SeanSylwester/Senior-Design-Project/Block Descriptions/Old/Laser Block.docx

# Laser ToF Sensor

# I. Introduction

The purpose of this document is to describe the Laser Time of Flight (ToF) Sensor block of the Wearable Sensor for the Blind ECE Senior Capstone Project to other engineers with enough detail such that they would be able to reproduce and test this block using only this document as reference. The Laser ToF block is implemented using a band of many VL53L0X ToF Ranging Sensor from ST Microelectronics on Adafruit breakout boards. Included in this document are an overview of the block, a schematic and wiring diagram, the properties of the interfaces with the other blocks in the system and testing procedures for each, and reasoning for why this design is the best solution for this block.

# II. Block Overview

The Laser ToF Sensor block will provide the distance to the nearest object in six 60° zones around the user to the system, which will use that information to set the system haptic feedback module that will convey that distance information to the user. The measurements taken need to be fast and accurate, so that the user can quickly and confidently navigate around obstacles in their environment. Fig. 1 below shows the black box diagram of the system. otsd_lsr_tf_snsr_envin represents the environmental input to this block, namely the distance to the nearest objects. lsr_tf_snsr_cntrllr_cd_data represents the I²C input from the microcontroller, which triggers measurements for the sensors and programs the ranging profile. pwr_spply_lsr_tf_snsr_dcpwr represents the connection to the power supply, which is regulated to 5V, and should draw about 30mA per sensor during measurements. And finally, cntrllr_cd_lsr_tf_snsr_data represents the I²C data output from this block to the microcontroller. All the properties for these interfaces can be found in Table 1.

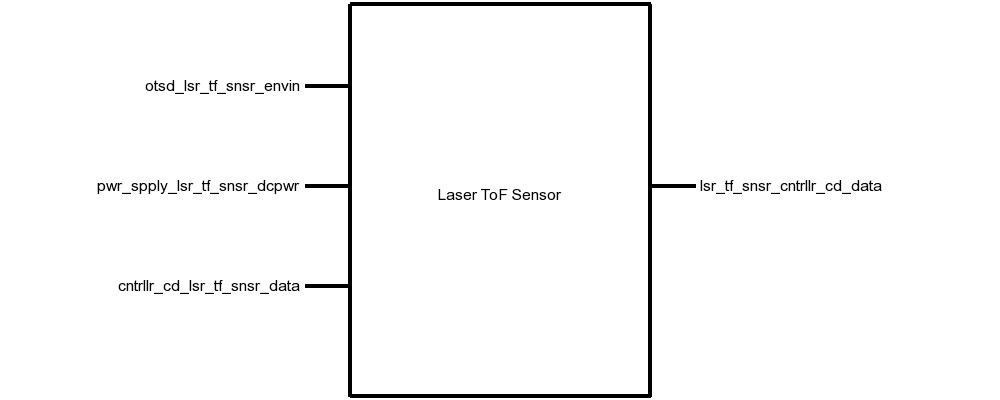
[picture p39: figure]

Fig. 1. Black Box Diagram of the Laser ToF Sensor Block
TABLE I.  Laser ToF Sensor Block Interfaces and Properties

Name | Properties
otsd_lsr_tf_snsr_envin | - Other: Accuracy: 12% - Other: Range: 0.4m(Black) 1m(White) - Other: Angle: 5° - Other: Measurement Time: 60ms
lsr_tf_snsr_cntrllr_cd_data | - Datarate: 115.2kHz - Messages: Sensor Data - Other: Measurement Time: 60ms - Protocol: I2C
cntrllr_cd_lsr_tf_snsr_data | - Datarate: 115.2kHz - Messages: Address Programming, Measurement Trigger, Measurement Read - Other: Measurement Time: 60ms - Protocol: I2C
pwr_spply_lsr_tf_snsr_dcpwr | - Inominal: 20µA ± 10% per sensor (between measurements) - Ipeak: 30mA per sensor (during measurement) - Vmax: 5V - Vmin: 3V

# III. Verification

This section details the testing procedures to verify every property listed in Table 1. All tests must be passed successfully before this block will be integrated into the rest of the system. Testing will be completed using a single Adafruit breakout board.

## A. Power and Communication Testing

This test will verify the power requirements for this block on the pwr_spply_lsr_tf_snsr_dcpwr interface, and the communication requirements on the cntrllr_cd_lsr_tf_snsr_data and lsr_tf_snsr_cntrllr_cd_data interfaces.

1. Connect a VL53L0X sensor to a DC power supply that can display current, set to 3V, via the pwr_spply_lsr_tf_snsr_dcpwr interface.
2. Connect a microcontroller using I2C at 115.2kHz to the cntrllr_cd_lsr_tf_snsr_data and lsr_tf_snsr_cntrllr_cd_data interfaces.
3. Load a test program on the microcontroller than takes a measurement for 200ms, then idles for 200ms.
4. Note the current displayed on the DC power supply during a measurement, and during idle.
5. Repeat steps 1-4 with the DC power supply set to 5V.

PASS: This test passes if the current draw never exceeds 30mA, and if the I2C interface communication links at 115.2kHz.

Link to Video (https://drive.google.com/drive/u/1/folders/1-_lIgtS_F6LOhz8X-mATpoxzoEysoKYl)

## B. Measurement

This test will verify the measurement requirements for this block on the otsd_lsr_tf_snsr_envin interface.

1. Connect a VL53L0X sensor to a DC power supply set to 2.8V via the pwr_spply_lsr_tf_snsr_dcpwr interface.
2. Connect a microcontroller using I2C at 115.2kHz to the cntrllr_cd_lsr_tf_snsr_data and lsr_tf_snsr_cntrllr_cd_data interfaces.
3. Load a test program on the microcontroller than takes a measurement for 60ms, then prints out the distance measurement, then idles for 40ms.
4. Place a white object 1m directly in front of the sensor and note if the sensor detects the object.
5. Place a black object 0.4m directly in front of the sensor and note if the sensor detects the object.
6. Place a white object 30cm away, and 3cm off-center (5°) and note if the sensor detects the object.
7. Place a white object 30cm directly in front of the sensor and note if the distance measurement is within 10% of 50cm.

PASS: If the the measurements complete in less than 60ms, objects in steps 4, 5, and 6 were detected, and the object in step 7 was detected within 10%.

Link to Video (https://drive.google.com/drive/u/1/folders/1-_lIgtS_F6LOhz8X-mATpoxzoEysoKYl)

# IV. Design

The schematic in Fig. 2 presents this block’s design, including the interfaces of this block to the rest of the system. Table 2 provides validation for each of the properties listed in Table 1 using the ST Microelectronics datasheet and the Adafruit .

## A. Wiring Diagram

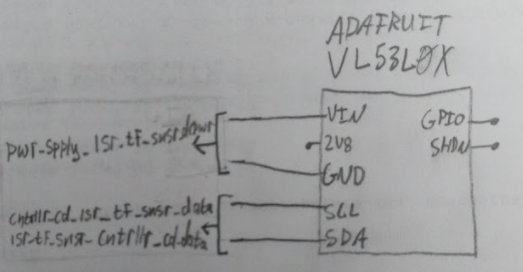
[picture p40: figure]

Fig. 2. Wiring Diagram for the Laser ToF Sensor Block

## B. Design Validation

For this block, the Adafruit breakout board was chosen to interface with the VL53L0X sensor. That sensor was chosen because it fits the low cost, low power, medium range, high accuracy, and fast performance that this project required of the Laser ToF Sensor block, and the breakout board was chosen to reduce prototyping time, and to reduce the number of components that need to be sourced for this block.

TABLE II.  Interface Property Validation for the DIsplay Block

Property | Validation

otsd_lsr_tf_snsr_envin
Other: Accuracy: 12% | Table 12 of the VL53L0X Datasheet states that the worst-case accuracy is 12% [1].
Other: Range: 0.4m(Black) 1m(White) | Table 11 of the VL53L0X Datasheet states that the minimum range indoors is 1.2m for a white object, and 0.7m for a grey object [1].
Other: Angle: 5° | VL53L0X Datasheet states that the FOV of the sensor is 25° [1].
Other: Measurement Time: 60ms | Table 13 of the VL53L0X Datasheet states that minimum timing budget is 20ms [1].

lsr_tf_snsr_cntrllr_cd_data
Datarate: 115.2kHz | Table 3 of the VL53L0X Datasheet states that the maximum I2C operating frequency is 400kHz
Messages: Sensor Data | Section 2 of the VL53L0X Datasheet states that Sensor Data can be sent over I2C [1].
Other: Measurement Time: 60ms | Table 13 of the VL53L0X Datasheet states that minimum timing budget is 20ms [1].
Protocol: I2C | Section 3 of the VL53L0X Datasheet states that I2C is the control interface required [1].

cntrllr_cd_lsr_tf_snsr_data
Datarate: 115.2kHz | Table 3 of the VL53L0X Datasheet states that the maximum I2C operating frequency is 400kHz
Messages: Address Programming, Measurement Trigger, Measurement Read | Section 2 of the VL53L0X Datasheet states that Address Programming, Measurement Trigger, and Measurement Read commands can be sent over I2C [1].
Other: Measurement Time: 60ms | Table 13 of the VL53L0X Datasheet states that minimum timing budget is 20ms [1].
Protocol: I2C | Section 3 of the VL53L0X Datasheet states that I2C is the control interface required [1].

pwr_spply_lsr_tf_snsr_dcpwr
Inominal: 20µA ± 10% per sensor (between measurements) | Table 9 of the VL53L0X Datasheet states that the inter-measurement current consumption is 16µA [1].
Ipeak: 30mA per sensor (during measurement) | Table 9 of the VL53L0X Datasheet states that the measurement current consumption is 19mA [1].
Vmax: 5V | The overview page for the Adafruit breakout board specifies that the input voltage range is 3-5V [2].
Vmin: 3V | The overview page for the Adafruit breakout board specifies that the input voltage range is 3-5V [2].

##### References

[1] ST Microelectronics, “World smallest Time-of-Flight ranging and gesture detection sensor,” VL53L0X production datasheet, May 2016
[2] Adafruit and T. Dicola, “Adafruit VL53L0X Time of Flight Micro-LIDAR Distance Sensor Breakout,” Adafruit VL53L0X Time of Flight Micro-LIDAR Distance Sensor Breakout, 23-Nov-2016. [Online]. Available: https://learn.adafruit.com/adafruit-vl53l0x-micro-lidar-distance-sensor-breakout/overview. [Accessed: 03-Dec-2017].
