SeanSylwester/Senior-Design-Project/PCB stuff/OLD/layout.pdf

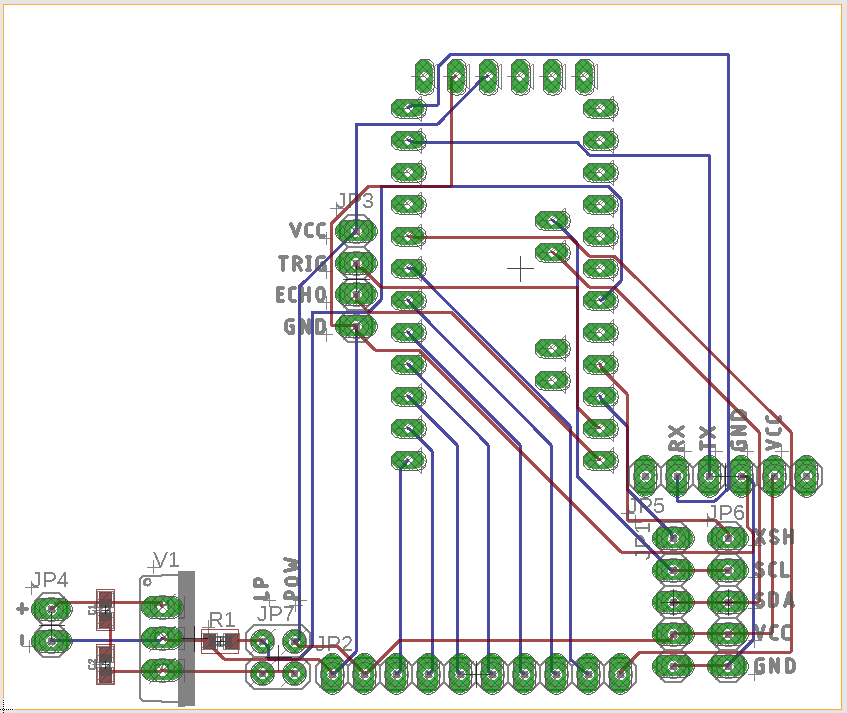
[picture p43: page 1]
