SeanSylwester/Senior-Design-Project/PCB stuff/OLD/PCB Layout.pdf

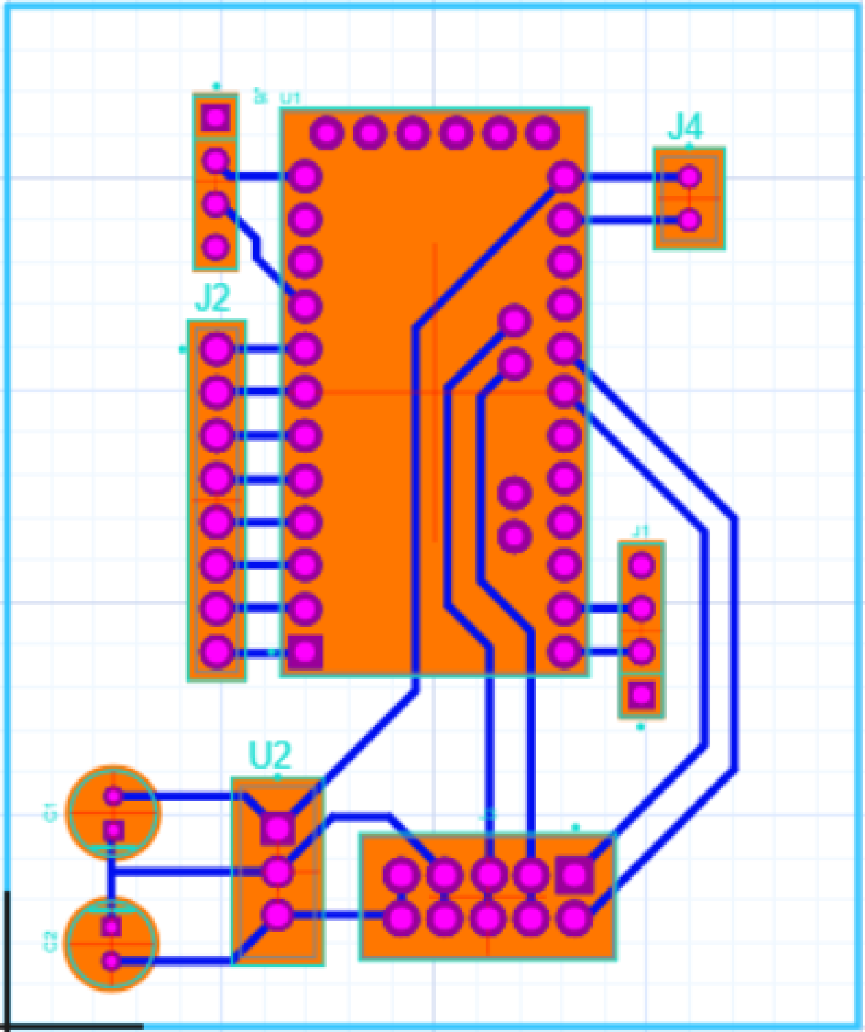
[picture p44: page 1]
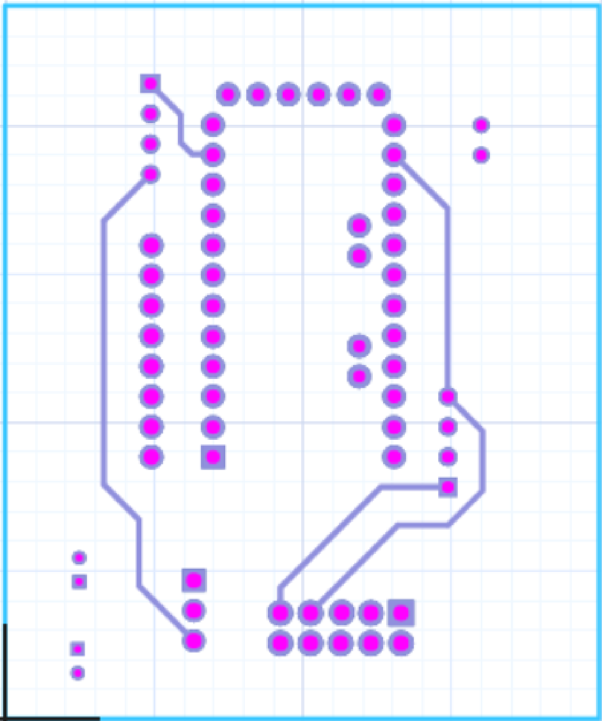
[picture p45: page 2]
