SeanSylwester/Senior-Design-Project/PCB stuff/OLD/Laser Sensor PCB/Old/VL53L0X Layout.pdf

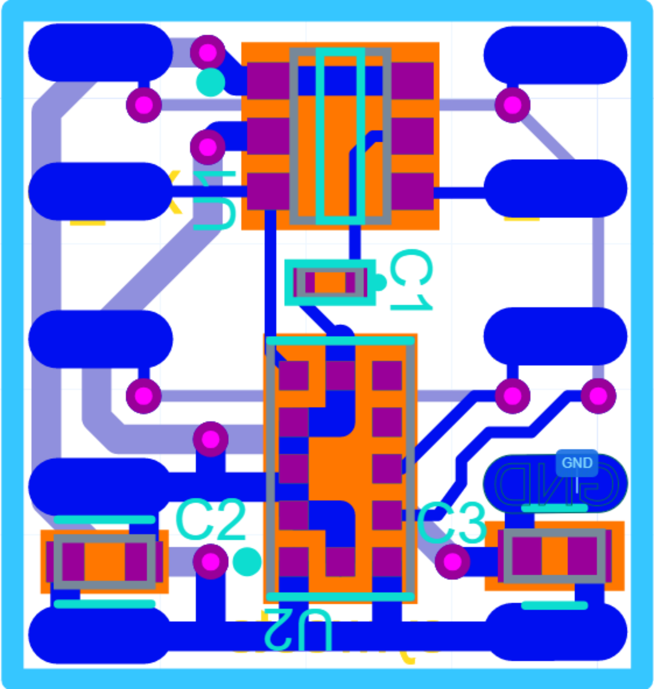
[picture p46: page 1]
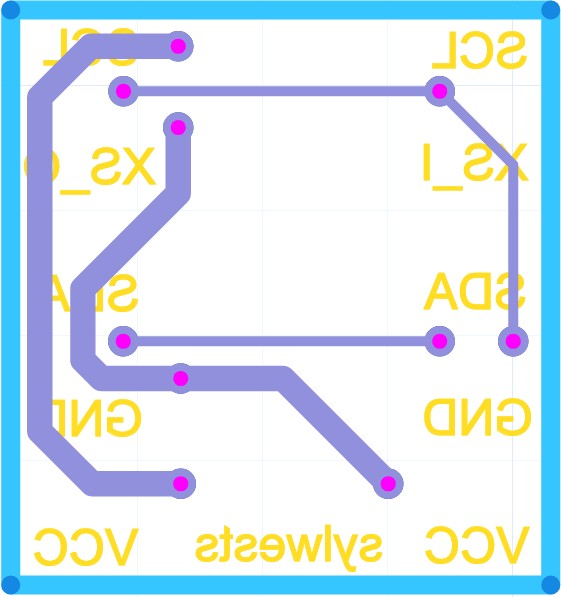
[picture p47: page 2]
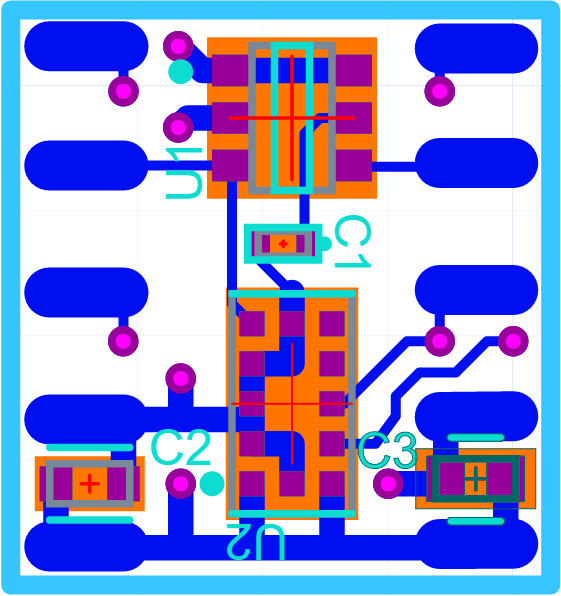
[picture p48: page 3]
