SeanSylwester/Senior-Design-Project/black box diagram.jpg

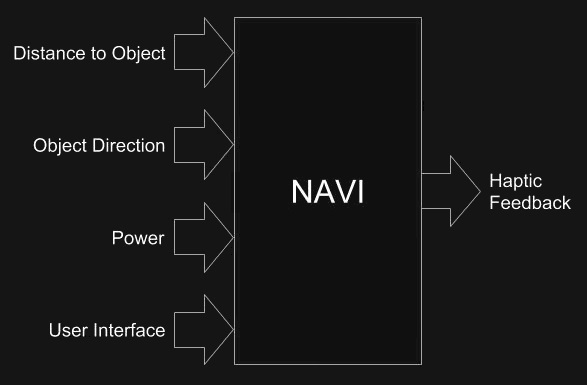
black box diagram.jpg
