SeanSylwester/Senior-Design-Project/Laser Sensor PCB/New/Bottom.PNG

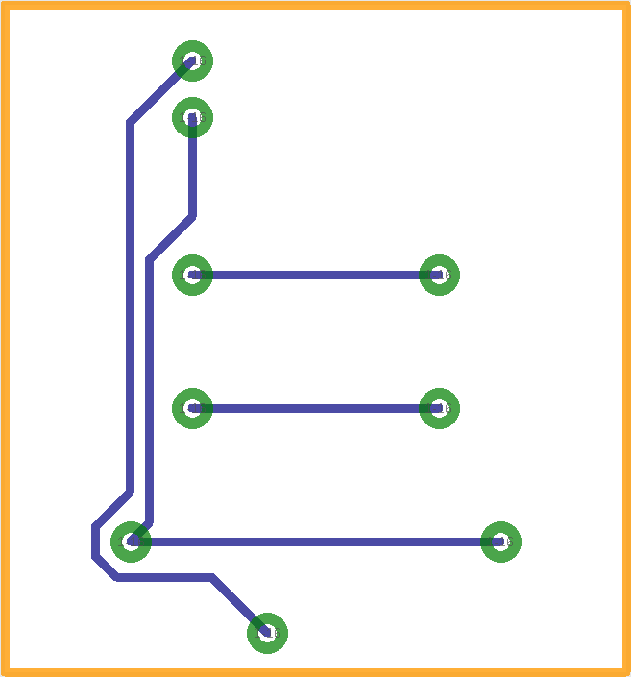
Laser Sensor PCB/New/Bottom.PNG
