SeanSylwester/Senior-Design-Project/Laser Sensor PCB/New/Bottom_Labeled.PNG

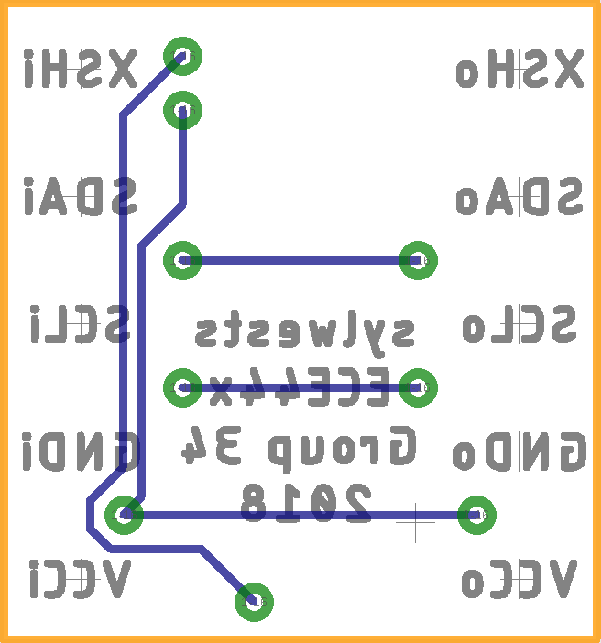
Laser Sensor PCB/New/Bottom_Labeled.PNG
