SeanSylwester/Senior-Design-Project/Laser Sensor PCB/New/Schematic.PNG

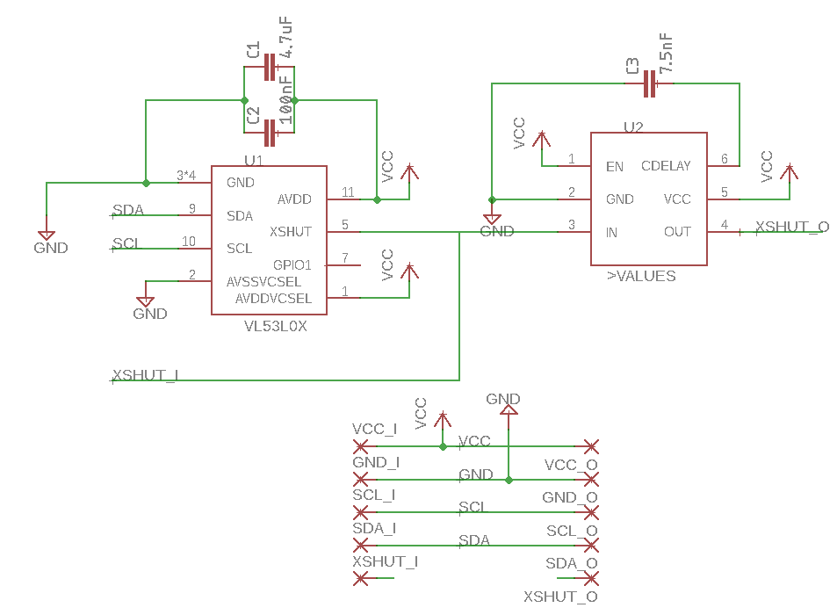
Laser Sensor PCB/New/Schematic.PNG
