SeanSylwester/Senior-Design-Project/Laser Sensor PCB/New/Top.PNG

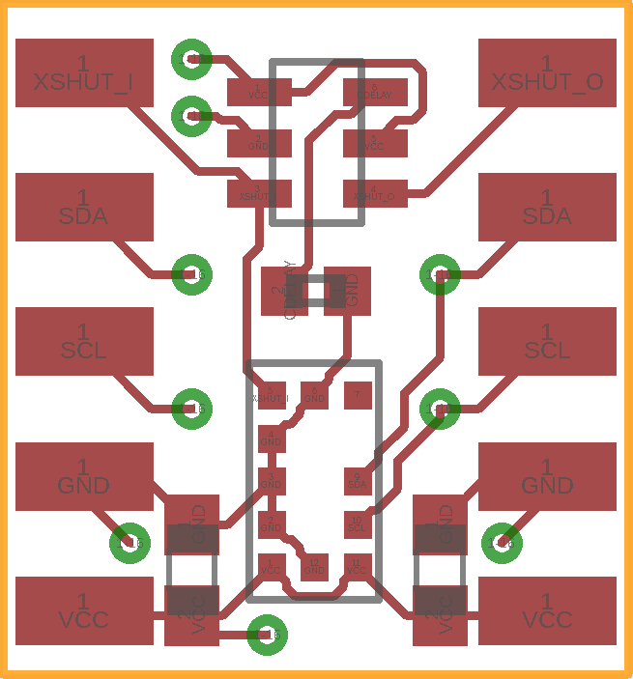
Laser Sensor PCB/New/Top.PNG
