SeanSylwester/Senior-Design-Project/system block diagram.png

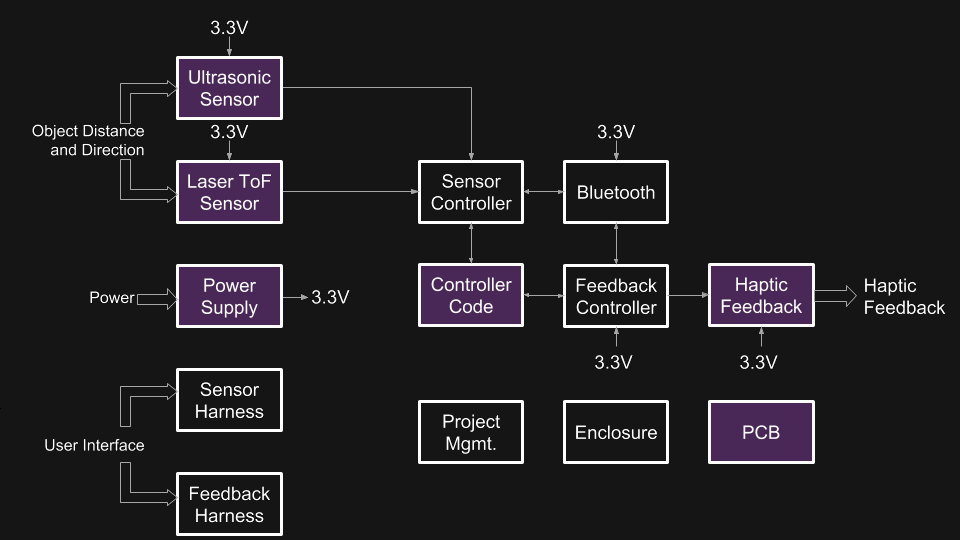
system block diagram.png
