SeanSylwester/Senior-Design-Project/Timeline.png

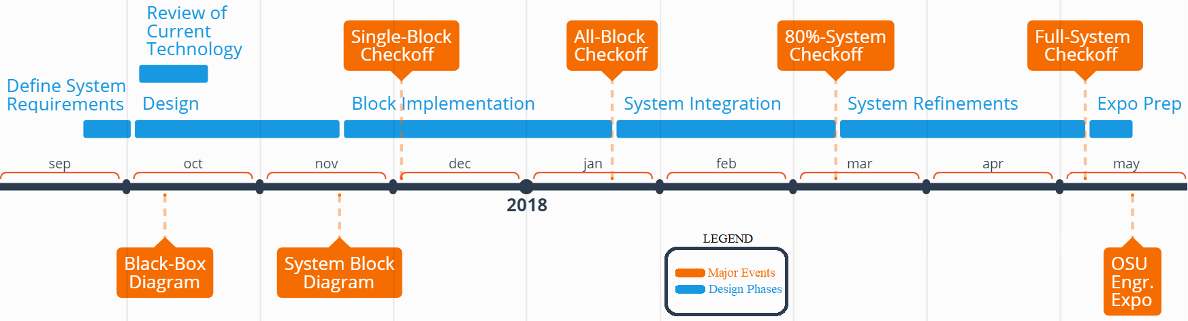
Timeline.png
