SeanSylwester/Senior-Design-Project/PCB stuff/OLD/PCB Schematic.pdf

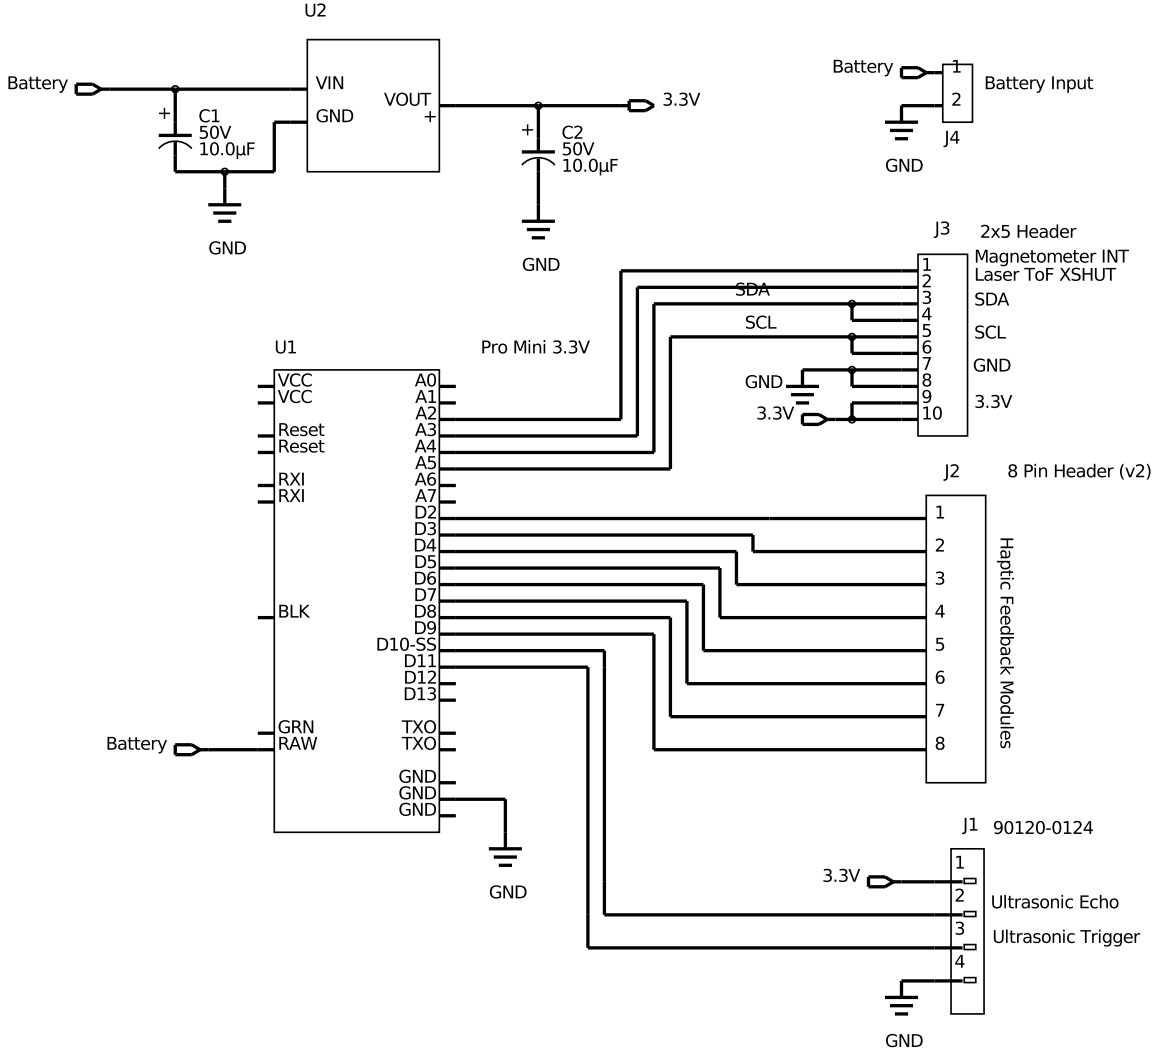
[picture p56: page 1]
