SeanSylwester/Senior-Design-Project/PCB stuff/OLD/Laser Sensor PCB/Old/VL53L0X Schematic.pdf

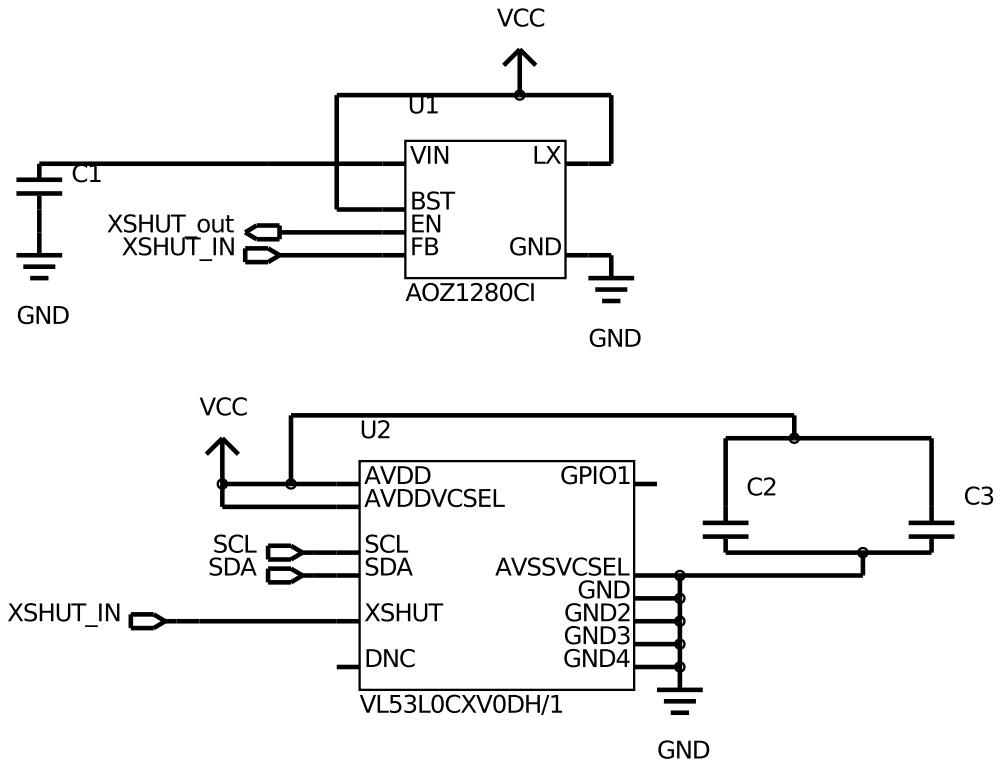
[picture p57: page 1]
