SeanSylwester/Senior-Design-Project/PCB stuff/motor PCB/motor_PCB.brd

## EAGLE design PCB stuff/motor PCB/motor_PCB.brd (2020-01-28)

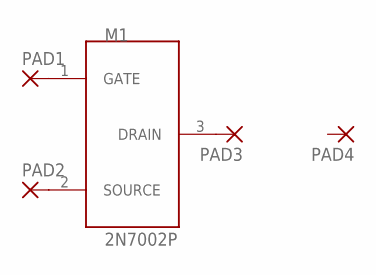
[picture p58: schematic motor_PCB.sch]

Parts:
M1: 2N7002P; TO-236AB
PAD1, PAD2, PAD3, PAD4: SMD2; SMD1,27-2,54

Connections:
unnamed: M1.1 (GATE), PAD1.1
unnamed: M1.2 (SOURCE), PAD2.1
unnamed: M1.3 (DRAIN), PAD3.1

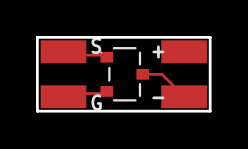
[picture p59: board motor_PCB.brd from above]

Board: 2 copper layers, 9.6 x 4.1 mm, 5 parts (0 on the bottom side), 3 nets.
