SeanSylwester/Senior-Design-Project/PCB stuff/VL53L0X Board/Schematic.brd

## EAGLE design PCB stuff/VL53L0X Board/Schematic.brd (2020-01-28)

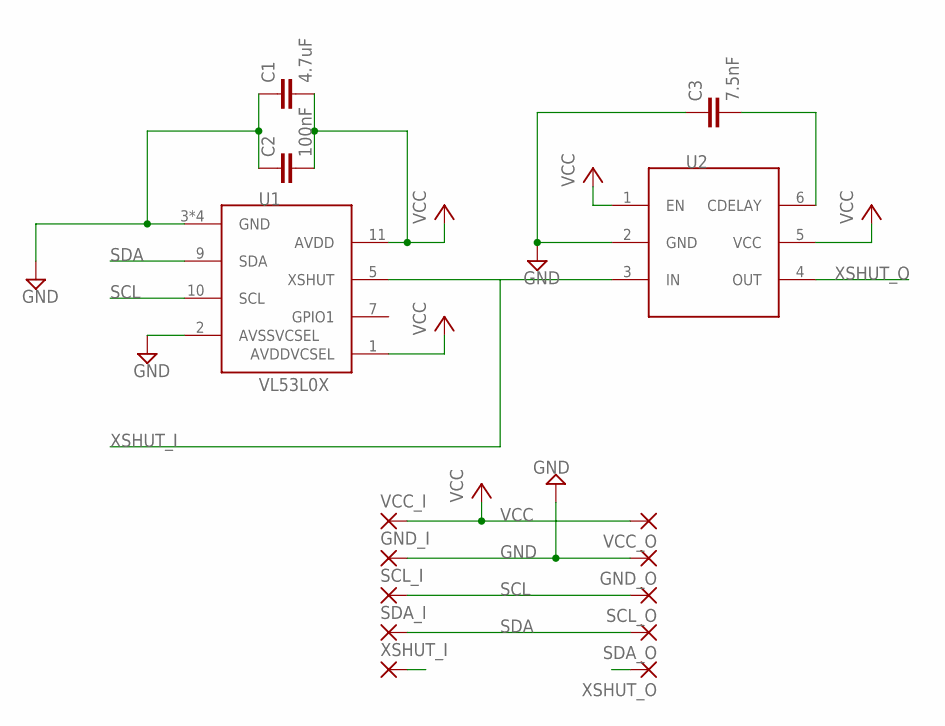
[picture p60: schematic Schematic.sch]

Parts:
C1: 4.7uF; 0603
C2: 100nF; 0603
C3: 7.5nF; 0402
GND_I: SMD2; SMD1,27-2,54
GND_O: SMD2; SMD1,27-2,54
SCL_I: SMD2; SMD1,27-2,54
SCL_O: SMD2; SMD1,27-2,54
SDA_I: SMD2; SMD1,27-2,54
SDA_O: SMD2; SMD1,27-2,54
U1: VL53L0X; OPTICAL_LGA12
U2: MAX6895AAZT+T; 6-THIN-SOT23
VCC_I: SMD2; SMD1,27-2,54
VCC_O: SMD2; SMD1,27-2,54
XSHUT_I: SMD2; SMD1,27-2,54
XSHUT_O: SMD2; SMD1,27-2,54

Connections:
CDELAY: C3.2, U2.6 (CDELAY)
GND: C1.1, C2.1, C3.1, GND_I.1, GND_O.1, U1.2 (AVSSVCSEL), U1.3 (GND), U1.4 (GND), U1.6 (GND), U1.12 (GND), U2.2 (GND)
SCL: SCL_I.1, SCL_O.1, U1.10 (SCL)
SDA: SDA_I.1, SDA_O.1, U1.9 (SDA)
VCC: C1.2, C2.2, U1.1 (AVDDVCSEL), U1.11 (AVDD), U2.1 (EN), U2.5 (VCC), VCC_I.1, VCC_O.1
XSHUT_I: U1.5 (XSHUT), U2.3 (IN), XSHUT_I.1
XSHUT_O: U2.4 (OUT), XSHUT_O.1

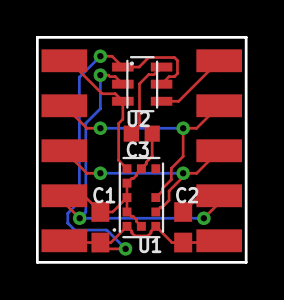
[picture p61: board Schematic.brd from above]

Board: 2 copper layers, 11.6 x 12.5 mm, 15 parts (0 on the bottom side), 7 nets.
