SeanSylwester/Senior-Design-Project/PCB stuff/sensor band/sensor_PCB.brd

## EAGLE design PCB stuff/sensor band/sensor_PCB.brd (2020-01-28)

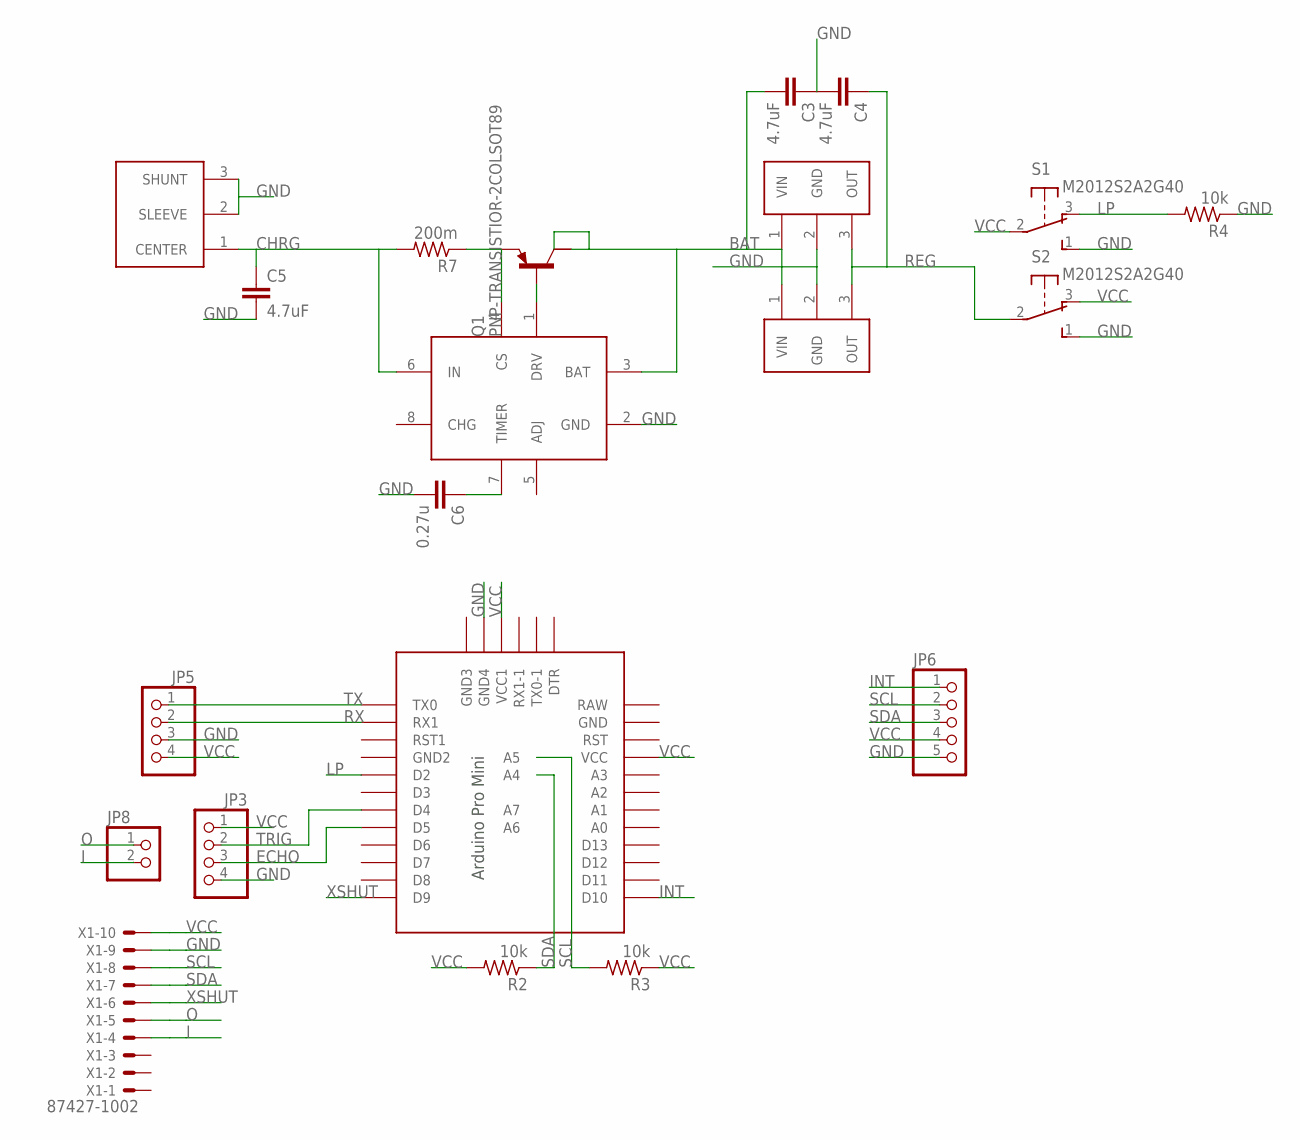
[picture p62: schematic sensor_PCB.sch]

Parts:
C3, C4, C5: 4.7uF; 0603
C6: 0.27u; 0805
JP3, JP5: PINHD-1X4; 1X04
JP6: PINHD-1X5; 1X05
JP8: PINHD-1X2; 1X02
Q1: PNP-TRANSISTIOR-2COLSOT89; SOT89
R2, R3, R4: 10k; R0603
R7: 200m; R0603
S1, S2: M2012S2A2G40
U$1: PRO-MINI-2
U$3: ADP2291; 8-MSOP
V3, V4: UCC283T-3; TO220V
V5: L712RAS
X1: 87427-1002

Connections:
BAT: C3.2, Q1.2 (C), Q1.2@1 (C/), U$3.3 (BAT), V3.1 (VIN), V4.1 (VIN)
CHRG: C5.1, R7.2, U$3.6 (IN), V5.1 (CENTER)
CS: Q1.3 (E), R7.1, U$3.4 (CS)
DRV: Q1.1 (B), U$3.1 (DRV)
ECHO: JP3.3, U$1.D5
GND: C3.1, C4.2, C5.2, C6.2, JP3.4, JP5.3, JP6.5, R4.1, S1.1 (S), S2.1 (S), U$1.GND3 (GND4), U$3.2 (GND), V3.2 (GND), V4.2 (GND), V5.2 (SLEEVE), V5.3 (SHUNT), X1.9
I: JP8.2, X1.4
INT: JP6.1, U$1.D10
LP: R4.2, S1.3 (O), U$1.D2
O: JP8.1, X1.5
REG: C4.1, S2.2, V3.3 (OUT), V4.3 (OUT)
RX: JP5.2, U$1.RX1
SCL: JP6.2, R3.2, U$1.A5, X1.8
SDA: JP6.3, R2.1, U$1.A4, X1.7
TIMER: C6.1, U$3.7 (TIMER)
TRIG: JP3.2, U$1.D4
TX: JP5.1, U$1.TX0
VCC: JP3.1, JP5.4, JP6.4, R2.2, R3.1, S1.2, S2.3 (O), U$1.VCC, U$1.VCC1, X1.10
XSHUT: U$1.D9, X1.6

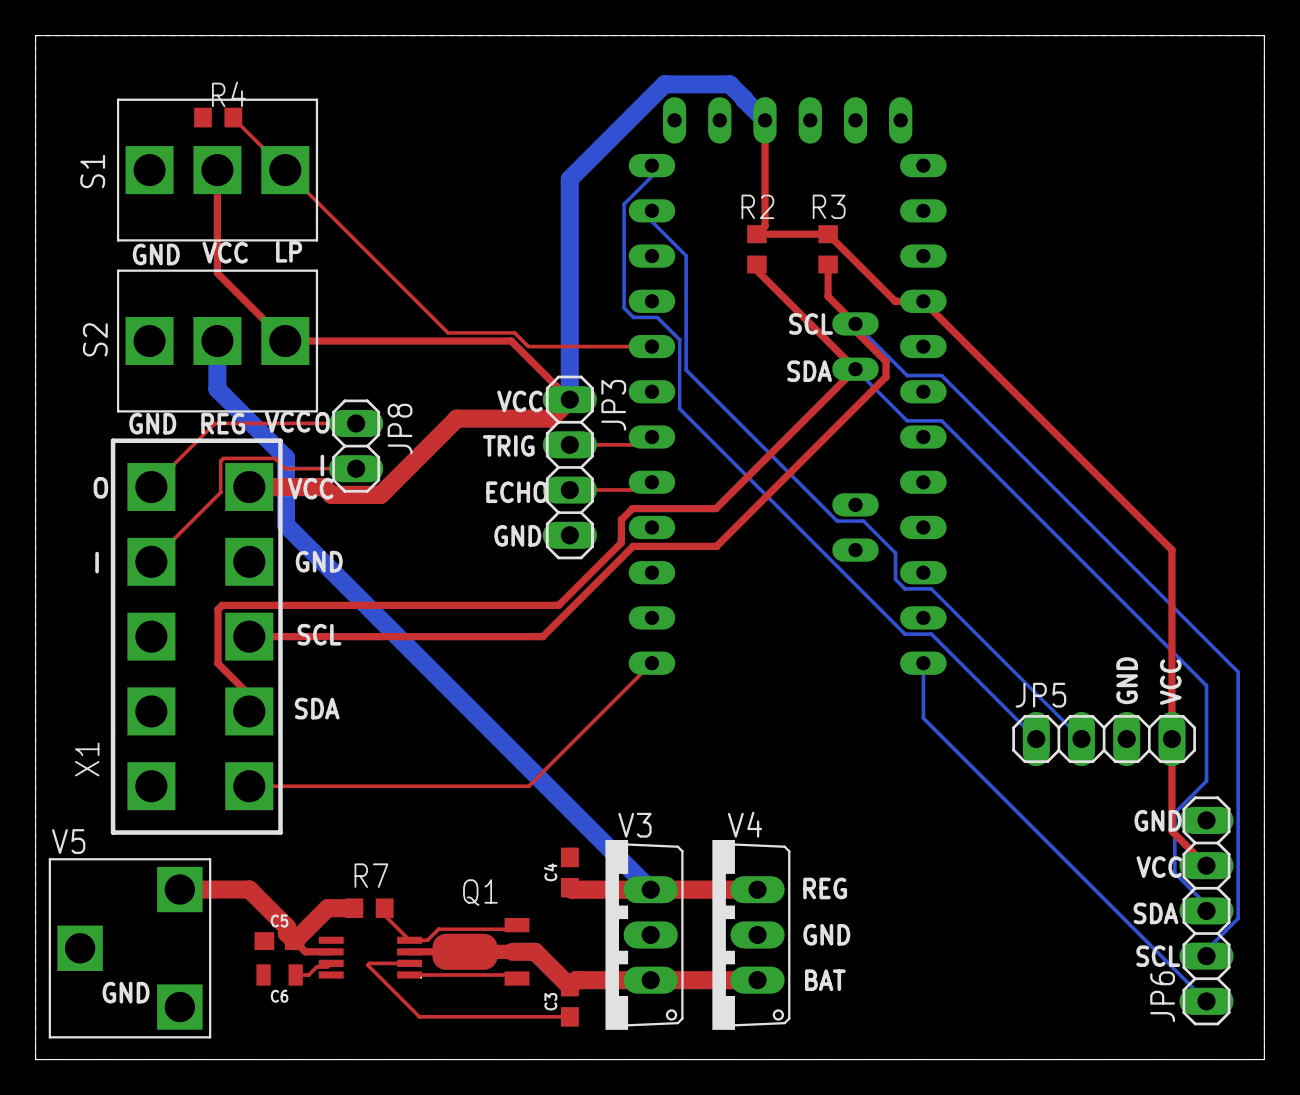
[picture p63: board PCB stuff/sensor band/sensor_PCB.brd from above]

Board: 2 copper layers, 69.0 x 57.5 mm, 21 parts (0 on the bottom side), 19 nets.
