SeanSylwester/Senior-Design-Project/eagle/sensor PCB/sensor_PCB.brd

## EAGLE design eagle/sensor PCB/sensor_PCB.brd (2020-01-28)

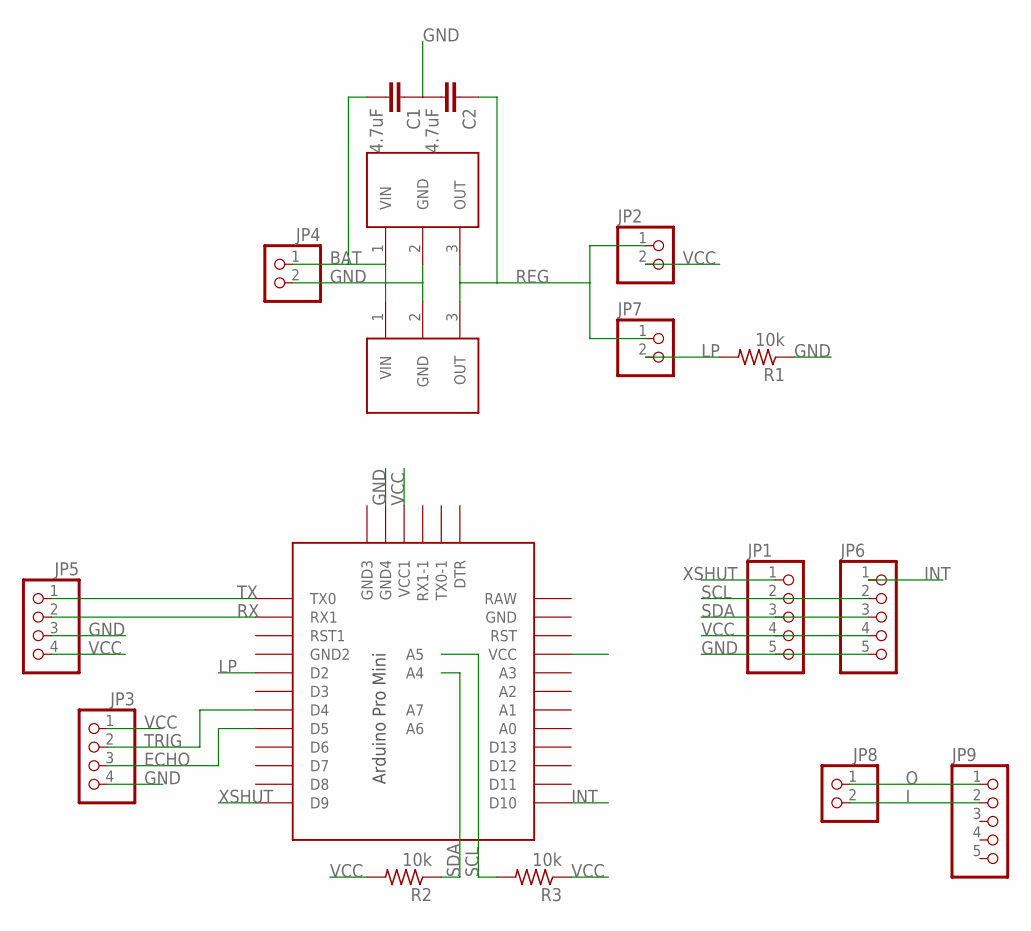
[picture p64: schematic sensor_PCB.sch]

Parts:
C1, C2: 4.7uF; 0603
JP1, JP6, JP9: PINHD-1X5; 1X05
JP2, JP4, JP7, JP8: PINHD-1X2; 1X02
JP3, JP5: PINHD-1X4; 1X04
R1, R2, R3: 10k; R0603
U$1: PRO-MINI-2
V1, V2: UCC283T-3; TO220V

Connections:
BAT: C1.2, JP4.1, V1.1 (VIN), V2.1 (VIN)
ECHO: JP3.3, U$1.D5
GND: C1.1, C2.2, JP1.5, JP3.4, JP4.2, JP5.3, JP6.5, R1.1, U$1.GND3 (GND4), V1.2 (GND), V2.2 (GND)
I: JP8.2, JP9.2
INT: JP6.1, U$1.D10
LP: JP7.2, R1.2, U$1.D2
O: JP8.1, JP9.1
REG: C2.1, JP2.1, JP7.1, V1.3 (OUT), V2.3 (OUT)
RX: JP5.2, U$1.RX1
SCL: JP1.2, JP6.2, R3.2, U$1.A5
SDA: JP1.3, JP6.3, R2.1, U$1.A4
TRIG: JP3.2, U$1.D4
TX: JP5.1, U$1.TX0
VCC: JP1.4, JP2.2, JP3.1, JP5.4, JP6.4, R2.2, R3.1, U$1.VCC1
XSHUT: JP1.1, U$1.D9

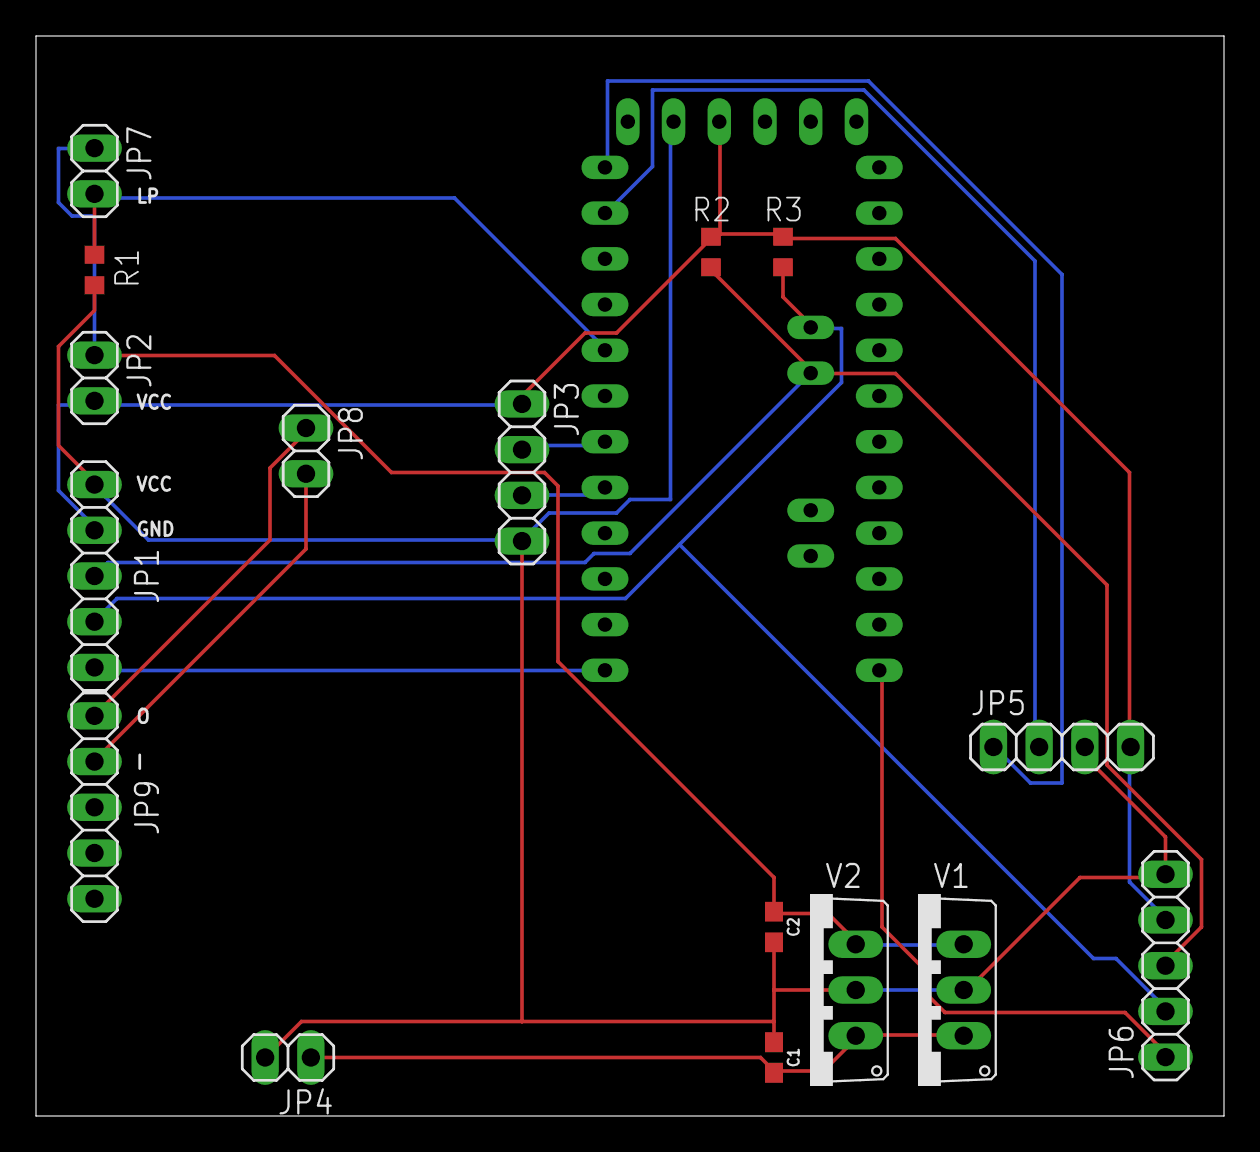
[picture p65: board eagle/sensor PCB/sensor_PCB.brd from above]

Board: 2 copper layers, 66.0 x 60.0 mm, 17 parts (0 on the bottom side), 15 nets.
